generot/driving-assistance-system/README.md

# Driving Assistance System
Дипломна работа 2023 г. на Мартин Наков - Система за напътстване на шофьор на базата на стерео компютърно зрение.
