generot/driving-assistance-system/docs/diagrams/cooler_dimensions.jpg

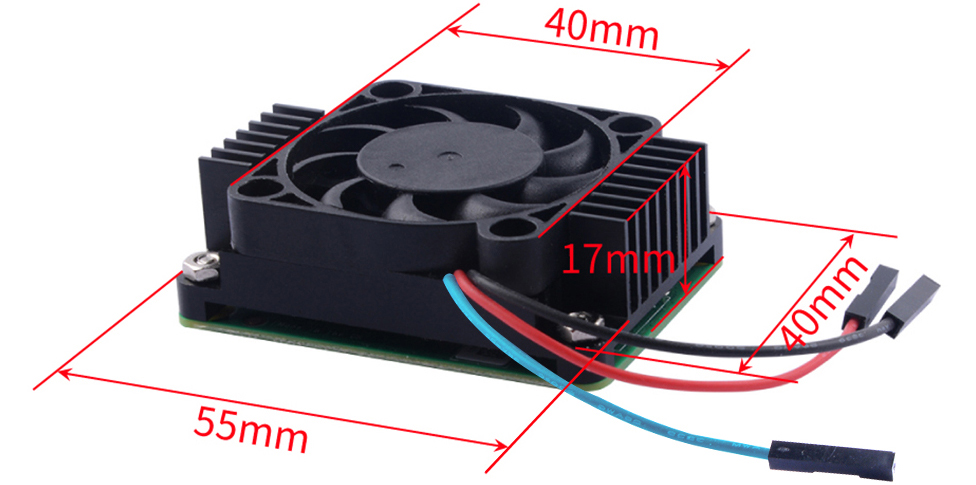
docs/diagrams/cooler_dimensions.jpg
