generot/driving-assistance-system/docs/diagrams/project_concept_5.png

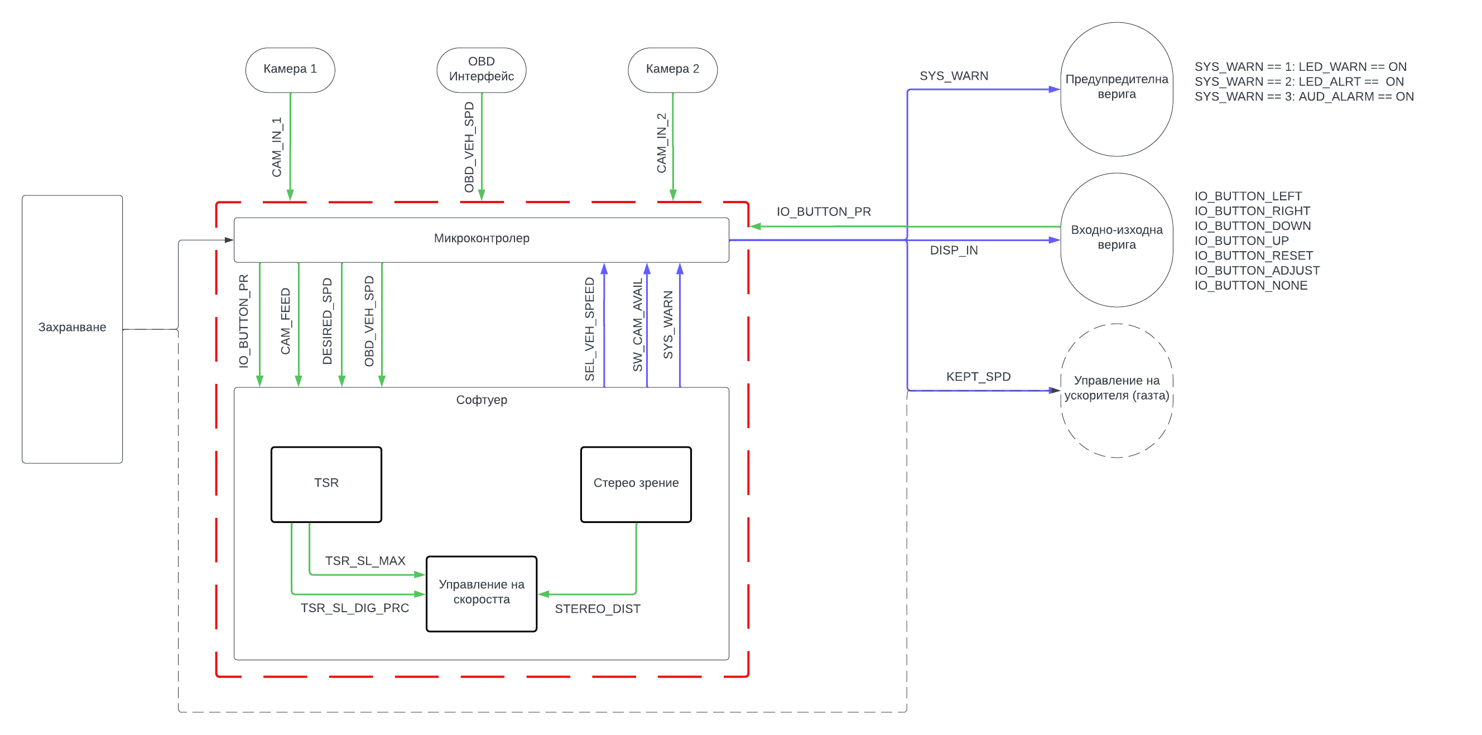
docs/diagrams/project_concept_5.png
