generot/driving-assistance-system/docs/math/concept.png

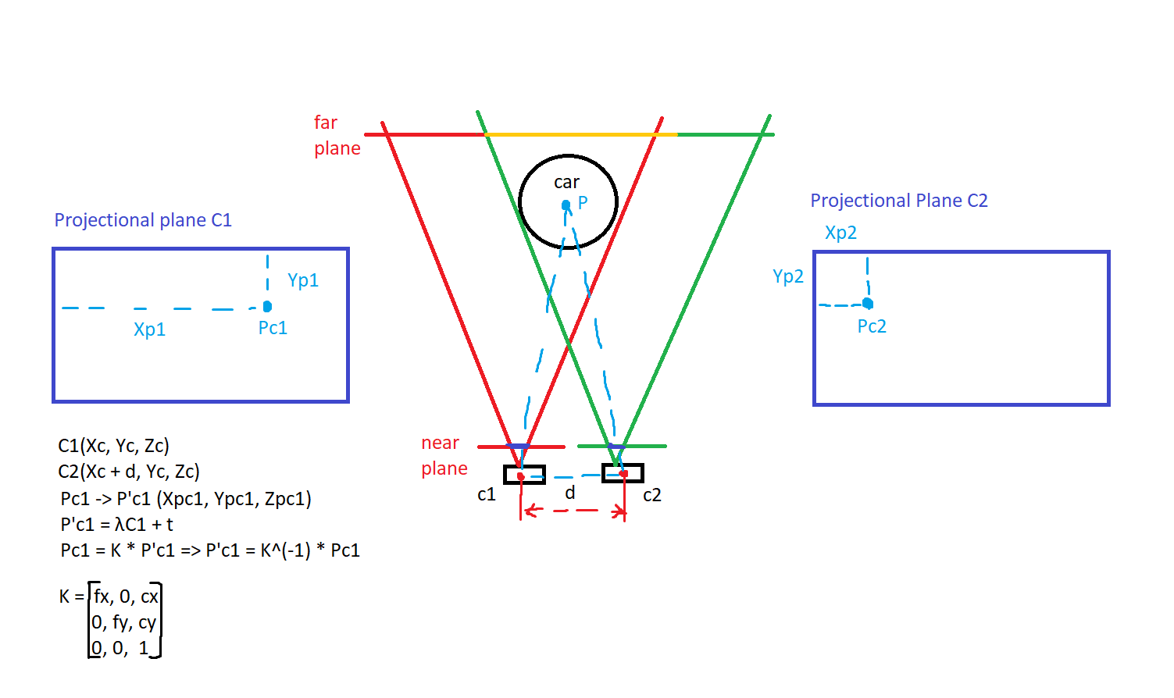
docs/math/concept.png
