generot/driving-assistance-system/models/signs/original/20.png

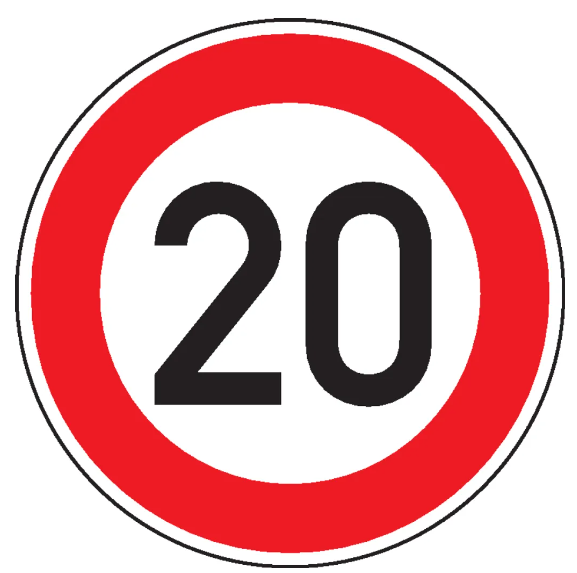
models/signs/original/20.png
