generot/driving-assistance-system/models/signs/original/30.png

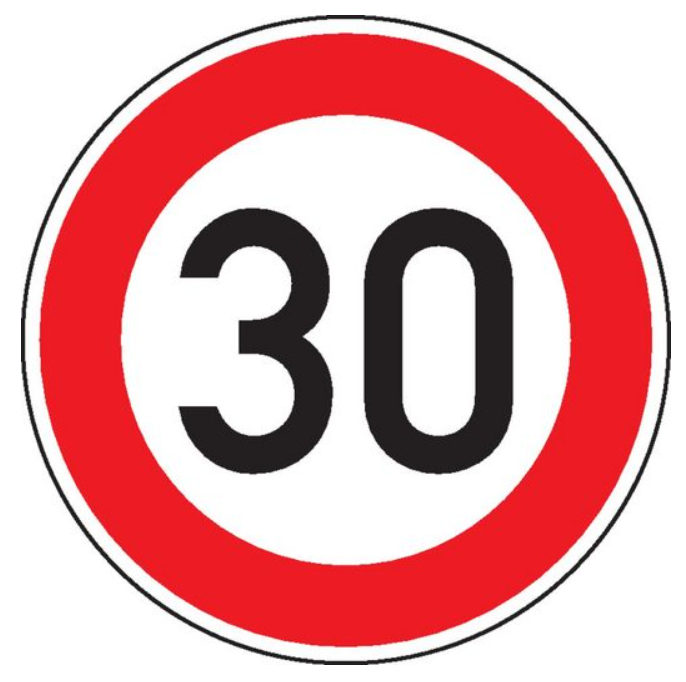
models/signs/original/30.png
