generot/driving-assistance-system/models/signs/original/40.png

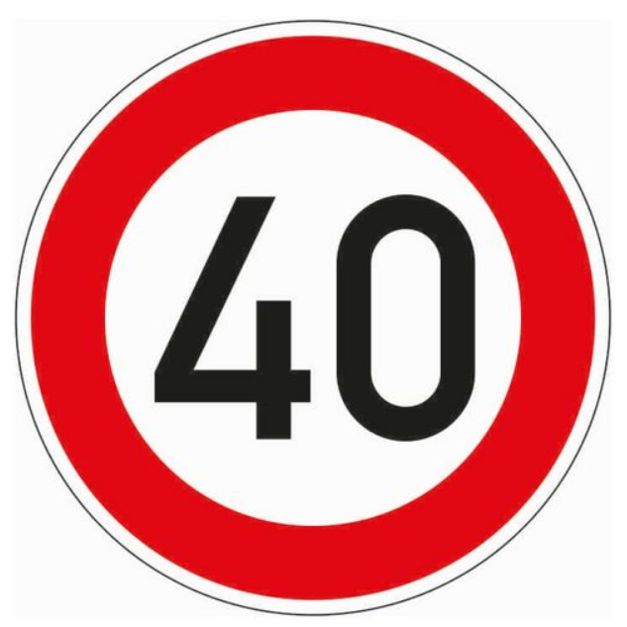
models/signs/original/40.png
