generot/driving-assistance-system/models/signs/original/45.png

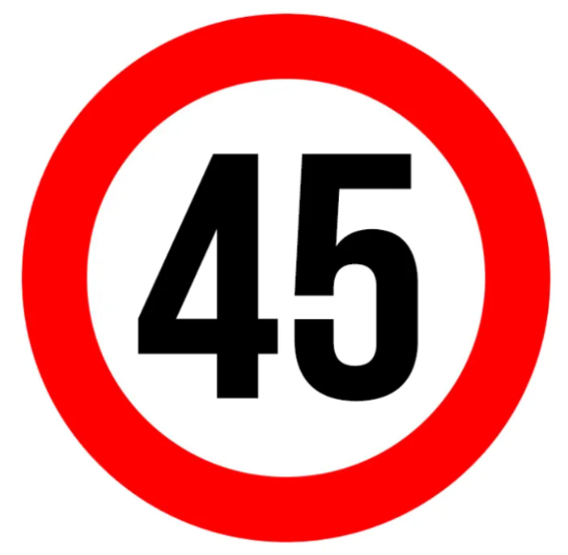
models/signs/original/45.png
