generot/driving-assistance-system/models/signs/original/50.png

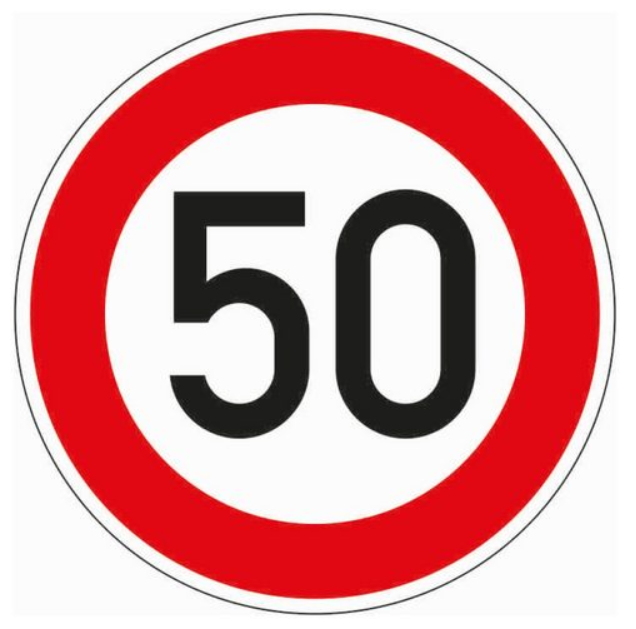
models/signs/original/50.png
