generot/driving-assistance-system/samples/sl_sign1.jpg

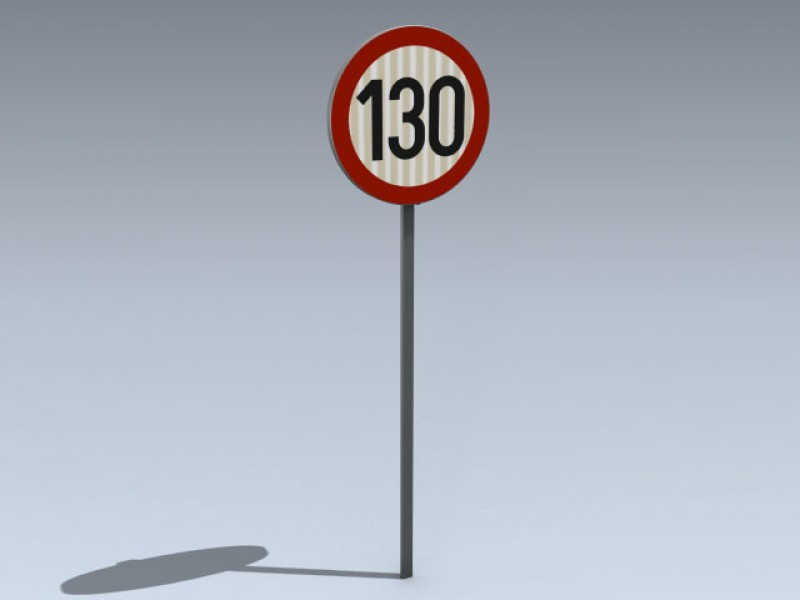
samples/sl_sign1.jpg
