generot/driving-assistance-system/samples/sl_sign3.png

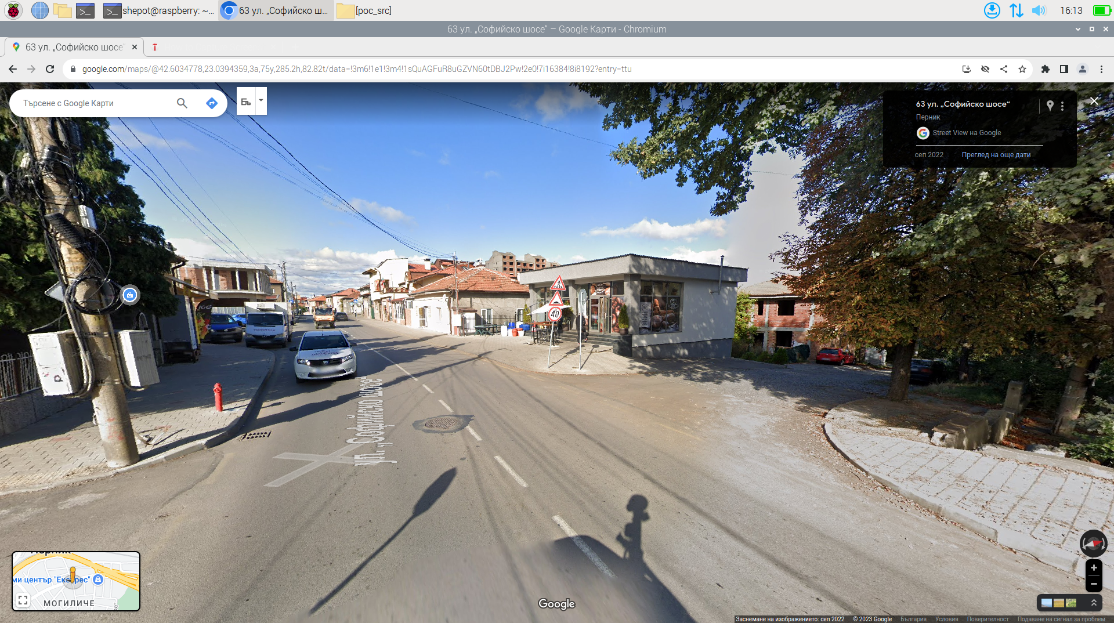
samples/sl_sign3.png
