generot/driving-assistance-system/samples/stereo/left_view_car.bmp

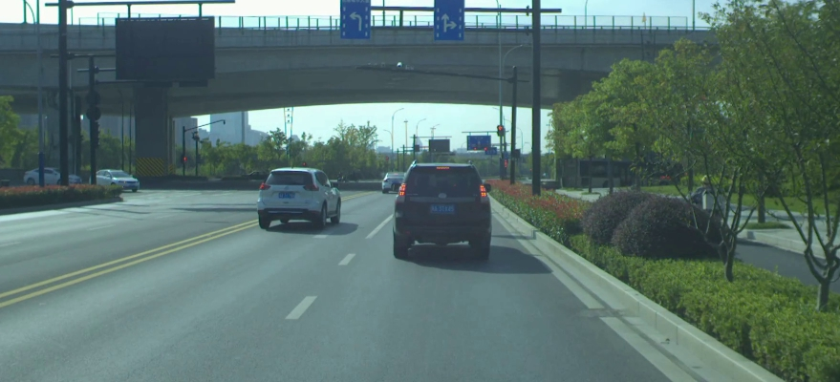
samples/stereo/left_view_car.bmp
