generot/driving-assistance-system/samples/stereo/right_view_car.bmp

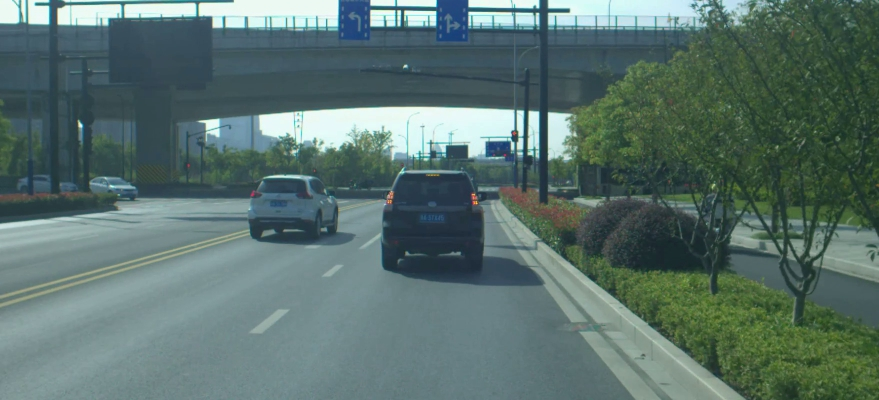
samples/stereo/right_view_car.bmp
