generot/driving-assistance-system/docs/components.xlsx

Sheet: LinkList
Order List
ID | Item | Quantity | Price |  | Provider | Availability (13.09.2023)
 |  |  | EUR (€) | BGN (лв.)
1 | Raspberry Pi Compute Module 4 (2 GB) | 1 | 47.19 | 92.0205 | https://buyzero.de/en/products/compute-module-4-cm4?variant=32090358251622 | In stock
2 |  |  | 62.90 | 122.655 | https://www.welectron.com/Raspberry-Pi-CM4002032-Compute-Module-32-GB-2-GB-RAM_1 | In stock
3 | Raspberry Pi Compute Module IO Board | 1 | 39.90 | 77.805 | https://www.welectron.com/Raspberry-Pi-Compute-Module-CM4-IO-Board_1 | In stock
4 |  |  | 30.87 | 61.74 | https://www.mouser.bg/ProductDetail/Raspberry-Pi/SC0326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 | In stock
5 | Raspberry Pi Camera v2 | 2 | 14.03 | 27.3585 | https://bg.farnell.com/raspberry-pi/rpi-8mp-camera-board/raspberry-pi-camera-board-v2/dp/3677845 | In stock
6 |  |  | 13.57 | 26.46 | https://www.mouser.bg/ProductDetail/Raspberry-Pi/SC0023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 | In stock
7 | Display (SM-RVT70HSMFWN00) | 1 | 50.98 | 99.41 | https://www.tme.eu/bg/details/sm-rvt70hsmfwn00/tft-displei/riverdi/ | In stock
8 |  |  | 49.26 | 96.06 | https://de.riverdi.com/product/high-brightness-ips-display-rvt70hsmfwn00-7-zoll-mipi-dsi-frame | In stock

Sheet: CM4_Vairant
ID | Item | Maximum Power Consumption |  |  | Price |  | Provider |  |  |  | Availability (05.09.2023)
 |  | U [V] | I [mA] | P [W] | EUR (€) | BGN (лв.)
1 | Raspberry Pi Compute Module 4 Lite (8 GB) | 5.0 | 1800.0 | 9.0 | 69.00 | 134.55 | https://www.digikey.bg/en/products/detail/raspberry-pi/SC0687/13530926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 |  |  |  | Out of stock
2 | Raspberry Pi Compute Module 4 Lite (4 GB) |  |  |  | 46.00 | 89.7 | https://www.digikey.bg/en/products/detail/raspberry-pi/SC0683/13530923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 |  |  |  | Out of stock
3 | Raspberry Pi Compute Module IO Board | 12.0 | 0.0 | 0.0 | 32.18 | 62.751 | https://bg.farnell.com/raspberry-pi/cm4io/compute-module-4-board-arm-cortex/dp/3563491 |  |  |  | Out of stock
4 |  |  |  |  | 30.87 | 61.74 | https://www.mouser.bg/ProductDetail/Raspberry-Pi/SC0326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 |  |  |  | In stock
5 | Raspberry Pi Camera v2 | 3.3 | 300.0 | 1.0 | 14.03 | 27.3585 | https://bg.farnell.com/raspberry-pi/rpi-8mp-camera-board/raspberry-pi-camera-board-v2/dp/3677845 |  |  |  | In stock
6 |  |  |  |  | 13.57 | 26.46 | https://www.mouser.bg/ProductDetail/Raspberry-Pi/SC0023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 |  |  |  | In stock
7 | Display (DEM 1024600H TMH-PW-N /O and SM-RVT70HSMFWN00) | 5.1 | 850.0 | 4.3 | 75.17 | 146.58 | https://www.tme.eu/bg/details/dem1024600h-tmhpno/tft-displei/display-elektronik/dem-1024600h-tmh-pw-n-o/ |  |  |  | In stock
8 |  |  |  |  | 49.26 | 96.06 | https://www.mouser.bg/ProductDetail/Riverdi/RVT70HSMFWN00?qs=7D1LtPJG0i2G%2FPnN%252BYe%252ByQ%3D%3D |  |  |  | Out of stock
9 | Запалка (Car Lighter Plug) | 0.0 | 0.0 | 0.0 | 3.03 | 5.9 | https://vikiwat.com/kabel-zahranvasch-1.2m-s-buksa-1.5x5.5x9.5mm-504071.html |  |  |  | In stock
10 |  |  |  |  | 1.49 | 2.9 | https://vikiwat.com/product/20033/shtepsel-za-zapalka-na-kola-12vdc.html |  |  |  | In stock
11 | DC/DC Converter * | UA | UA | UA | 3.68 | 7.176 | https://store.comet.bg/Catalogue/Product/51791/ |  |  |  | In stock
12 |  |  |  |  | 7.73 | 15.0735 | https://store.comet.bg/Catalogue/Product/46876/ |  |  |  | In stock
 | Total | UA | 2950.0 | 14.3 | UA |  | - |  |  |  | -
 | Notes |  | Variant 1a (8 GB RAM) |  |  |  |  | Additional Components
 | UA - Unapplicable |  | Item |  | Price (BGN) | ID |  | Item | Price (BGN) | Provider
 | IO платката (по спецификация) тегли толкова ток от източника, колкото е товара, свързан към нея (+- няколко mА) |  | RasPI CM4 Lite 8 GB |  | 134.55 | 1 |  | Seeed 114070161 | 22.91 | https://www.mouser.bg/ProductDetail/Seeed-Studio/114070161?qs=TuK3vfAjtkXtgDd7IWY4BQ%3D%3D
 |  |  | RasPI CMIO Board |  | 61.74 | 4
 |  |  | 2 x RasPI Camera v2 |  | 28.06 | 5
 | * - Тъй като по-голямата част от компонентите са за Raspberry PI по дизайн, DC/DC конвертор може би няма да е нужен, IO платката "би трябвало" да снабди всеки важен компонент с достатъчно ток. Евентуално, ако към веригата ще се добавя по-изискващ компонент (като серво/електромотор), може би няма да е зле да се вземе поне по-маломощния конвертор (46876) |  | SM-RVT70HSMFWN00 |  | 96.06 | 7
 |  |  | Car Lighter Plug |  | 5.90 | 9
 |  |  | DC/DC CNV 51791 |  | 7.17 | 11
 |  |  | Total |  | 333.48 | -
 |  |  | Variant 1b (4 GB RAM)
 |  |  | Item |  | Price (BGN) | ID
 |  |  | RasPI CM4 Lite 4 GB |  | 89.70 | 1
 |  |  | RasPI CMIO Board |  | 61.74 | 4
 |  |  | 2 x RasPI Camera v2 |  | 28.06 | 5
 |  |  | SM-RVT70HSMFWN00 |  | 98.65 | 7
 | В таблицата има някои компоненти, които са взаимнозаменяеми с други, които са по-евтини, но по-маломощни. Ще направя два възможни списъка с компоненти за купуване. |  | Car Lighter Plug |  | 5.90 | 9
 |  |  | DC/DC CNV 51791 |  | 7.17 | 11
 |  |  | Total |  | 314.13 | -

Sheet: RPI4_Variant
ID | Item |  |  | Maximum Power Consumption |  |  | Price |  | Provider | Availability (05.09.2023)
 |  |  |  | U [V] | I [mA] | P [W] | EUR (€) | BGN (лв.)
1 | Raspberry Pi 4 |  |  | 5.0 | 3000.0 | 15.0 | 68.96 | 134.472 | https://bg.farnell.com/raspberry-pi/rpi4-modbp-8gb/raspberry-pi-4-model-b-cortex/dp/3369503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 | Out of stock
 |  |  |  |  |  |  | 56.00 | 109.2 | https://www.tme.eu/bg/details/rpi-4b-4g/ednoplatkovi-kompiutri/raspberry-pi/raspberry-pi-4-4g-model-b/ | Out of stock
2 | Trust Spotlight |  |  | 5.0 | 300.0 | 1.5 | 23.13 | 45.1035 | https://bg.farnell.com/trust/16428/webcam-spotlight-webcam-pro-trust/dp/3498501 | In stock
3 | Dynamode M-1100M |  |  | 5.0 | 300.0 | 1.5 | 15.13 | 29.5035 | https://bg.farnell.com/dynamode/m-1100m/webcam-usb-2mp-microphone-led/dp/3531742 | In stock
4 | Display (DEM 1024600H TMH-PW-N /O and SM-RVT70HSMFWN00) |  |  | 5.1 | 850.0 | 4.3 | 75.17 | 146.58 | https://www.tme.eu/bg/details/dem1024600h-tmhpno/tft-displei/display-elektronik/dem-1024600h-tmh-pw-n-o/ | In stock
5 |  |  |  |  |  |  | 50.59 | 98.65 | https://www.tme.eu/bg/details/sm-rvt70hsmfwn00/tft-displei/riverdi/ | In stock
6 | Запалка (Car Lighter Plug) |  |  | 0.0 | 0.0 | 0.0 | 3.03 | 5.9 | https://vikiwat.com/kabel-zahranvasch-1.2m-s-buksa-1.5x5.5x9.5mm-504071.html | In stock
7 |  |  |  |  |  |  | 1.49 | 2.9 | https://vikiwat.com/product/20033/shtepsel-za-zapalka-na-kola-12vdc.html | In stock
8 | DC/DC Converter * |  |  | UA | UA | UA | 18.60 | 36.27 | https://www.tme.eu/bg/details/psd-30a-5/preobrazuvateli-dc-dc/mean-well/ | Out of stock
9 |  |  |  |  |  |  | 7.73 | 15.0735 | https://store.comet.bg/Catalogue/Product/46876/ | In stock
 | Total |  |  | UA | 4450.0 | 22.3 | UA |  | - | -
 | Variant 2
 | Item | Price (BGN) | ID
 | RasPI 4 | 134.47 | 1
 | 2 x Dynamode M-1100M | 59 | 3
 | SM-RVT70HSMF | 98.65 | 5
 | Car Lighter Plug | 5.9 | 6
 | DC/DC Converter | 15.07 | 9
 | Total | 336
