generot/driving-assistance-system/docs/schematics/aac/models_3d/MAX3232.STEP

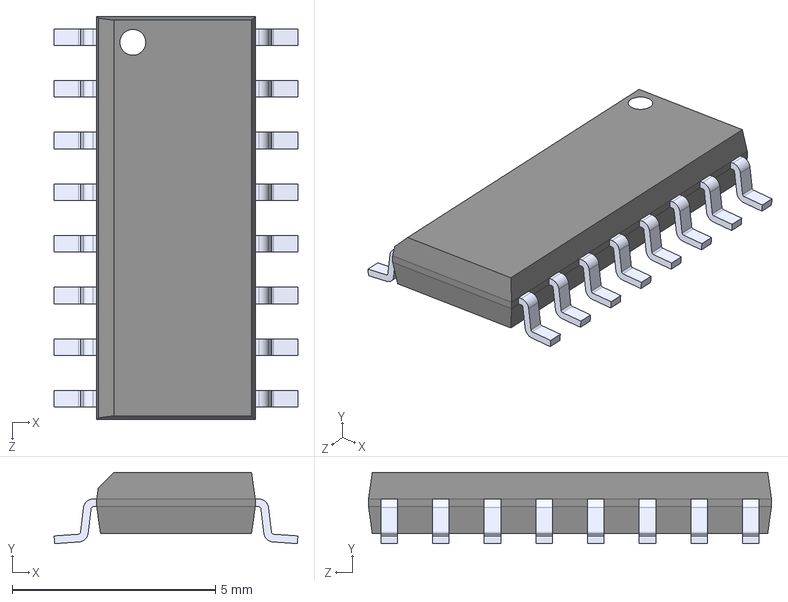
[picture p15: CAD file, 2023-11-07]
docs/schematics/aac/models_3d/MAX3232.STEP
5.99 x 1.75 x 9.91 mm
