generot/driving-assistance-system/docs/schematics/aac/models_3d/WE-PD4_Typ_L_4.stp

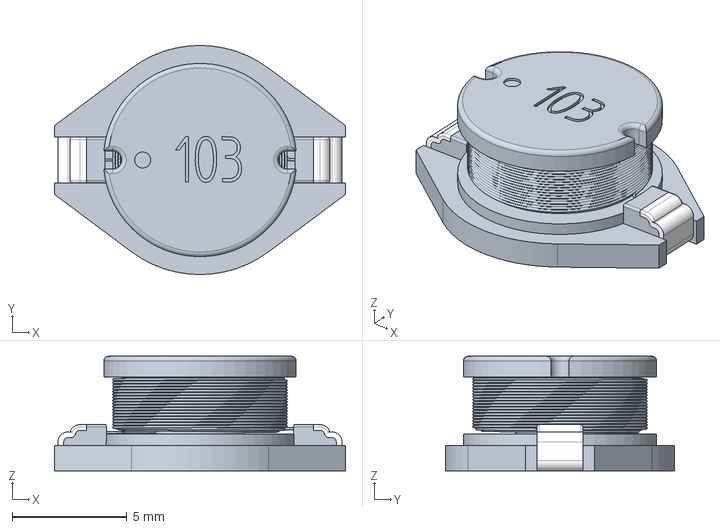
[picture p16: CAD file, 2023-11-07]
docs/schematics/aac/models_3d/WE-PD4_Typ_L_4.stp
12.7 x 10.0 x 5.00 mm
