generot/driving-assistance-system/docs/schematics/aac/models_3d/Trimmer_Piher_PT-15.step

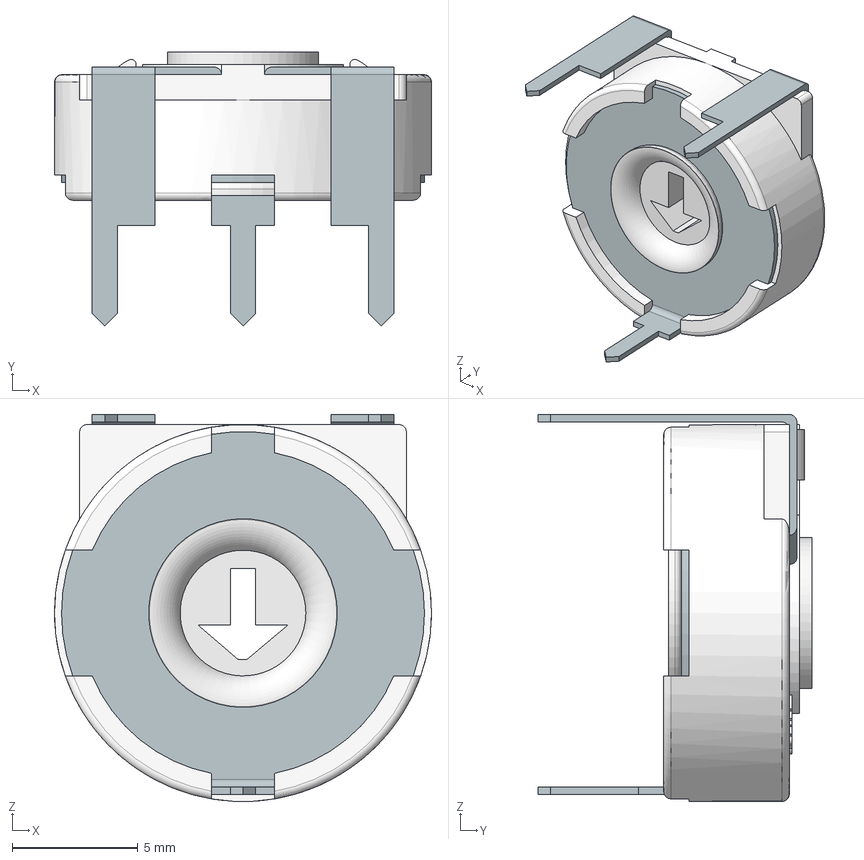
[picture p17: CAD file, 2023-11-07]
docs/schematics/aac/models_3d/Trimmer_Piher_PT-15.step
15.0 x 10.9 x 15.4 mm
Corps_PT-15
Axe
Broche 1
