generot/driving-assistance-system/docs/diagrams/L2_testing.png

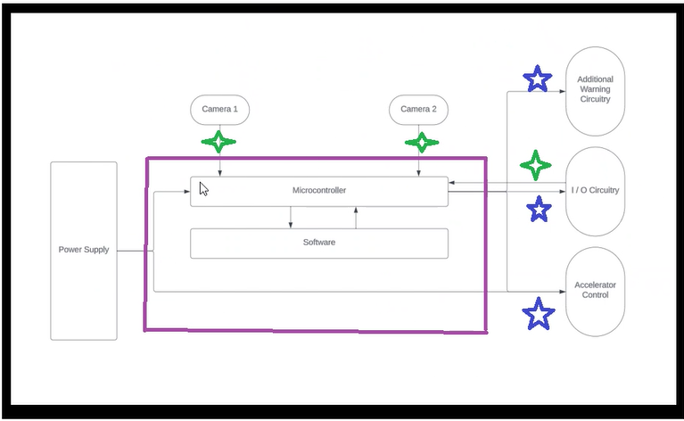
docs/diagrams/L2_testing.png
