generot/driving-assistance-system/samples/calibration/cm4/cam0/calib_3.jpg

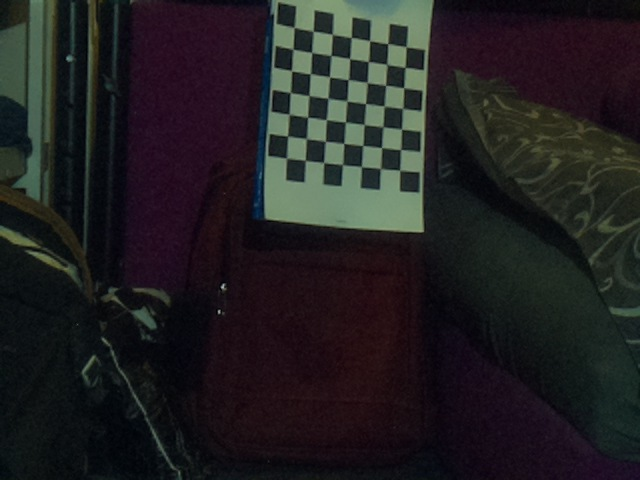
samples/calibration/cm4/cam0/calib_3.jpg
