generot/driving-assistance-system/samples/calibration/cm4/cam0/calib_13.jpg

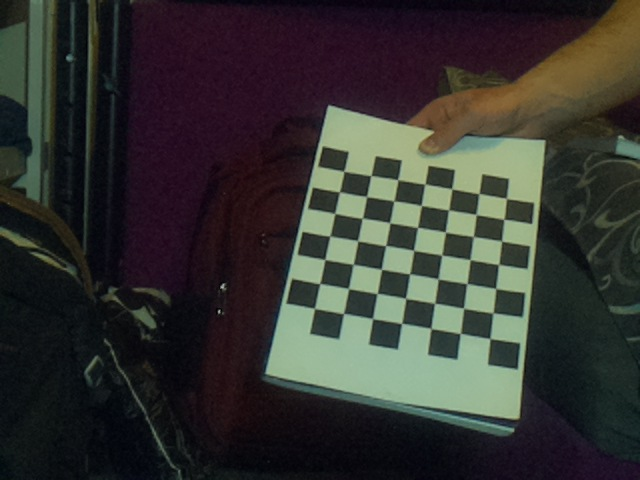
samples/calibration/cm4/cam0/calib_13.jpg
