generot/driving-assistance-system/samples/calibration/cm4/cam1/calib_1.jpg

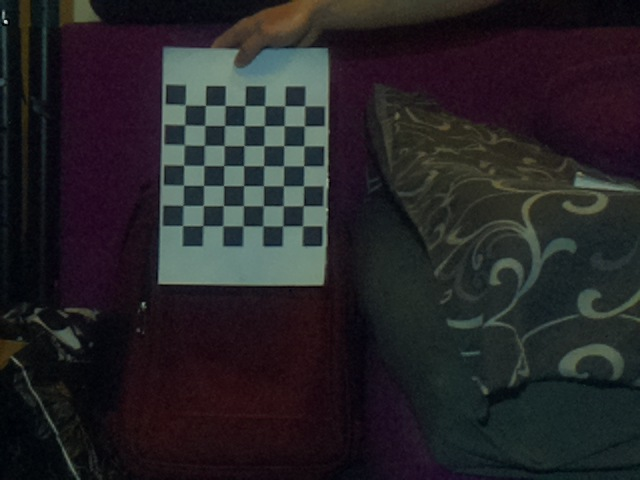
samples/calibration/cm4/cam1/calib_1.jpg
