generot/driving-assistance-system/samples/calibration/cm4/cam1/calib_13.jpg

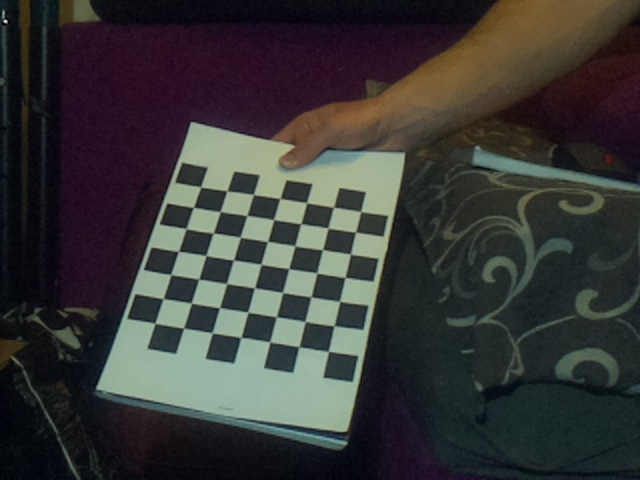
samples/calibration/cm4/cam1/calib_13.jpg
