generot/driving-assistance-system/samples/calibration/test/sam_a32_p1.jpg

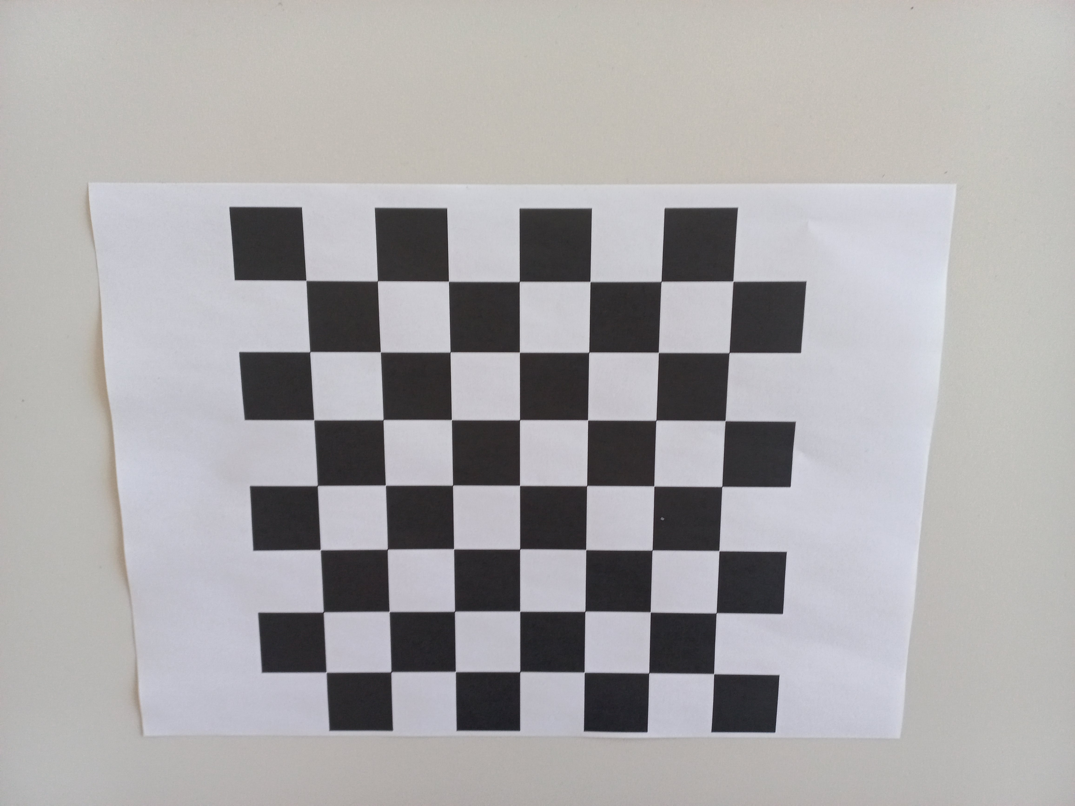
samples/calibration/test/sam_a32_p1.jpg
