generot/driving-assistance-system/samples/calibration/test/sam_a32_p3.jpg

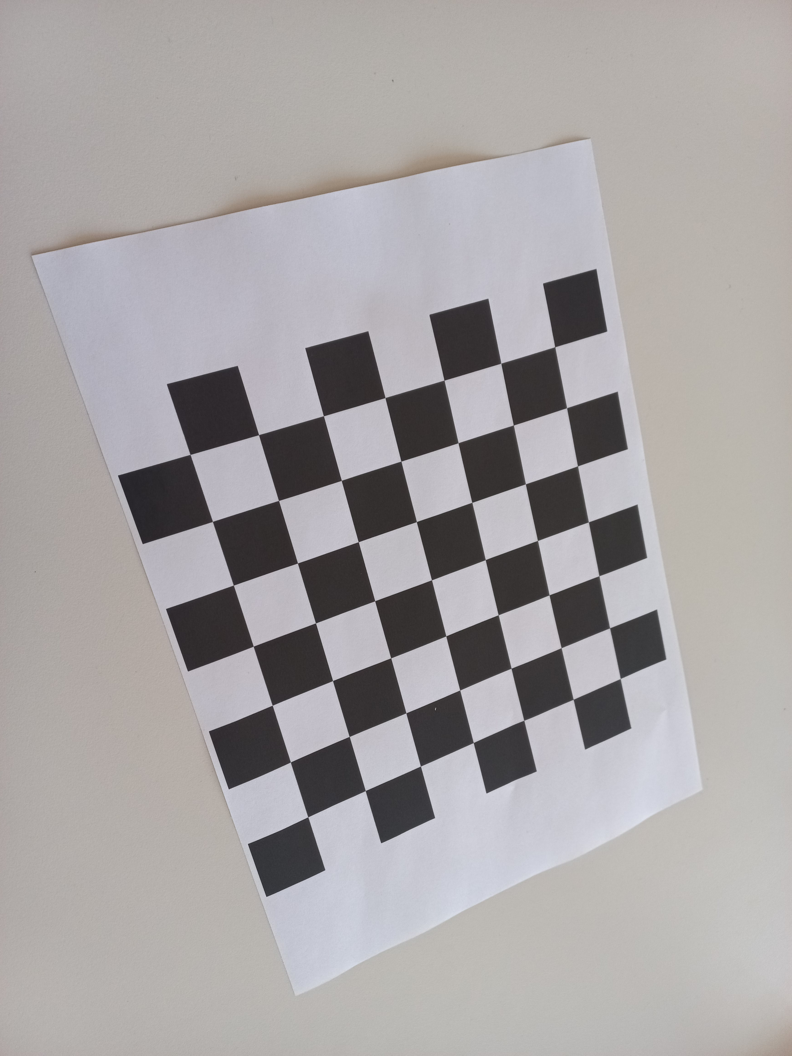
samples/calibration/test/sam_a32_p3.jpg
