generot/driving-assistance-system/samples/calibration/test/sam_a32_p4.jpg

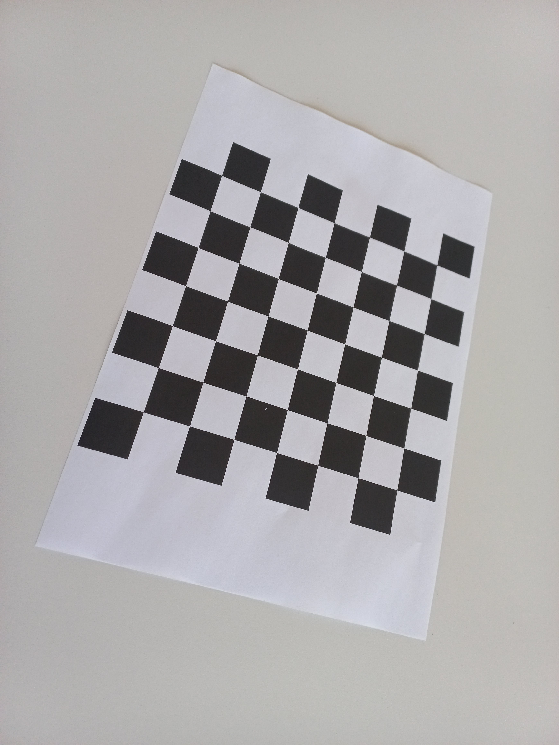
samples/calibration/test/sam_a32_p4.jpg
