generot/driving-assistance-system/docs/schematics/aac/Shield.kicad_pcb

## KiCad design docs/schematics/aac/Shield.kicad_pcb (2023-11-24)

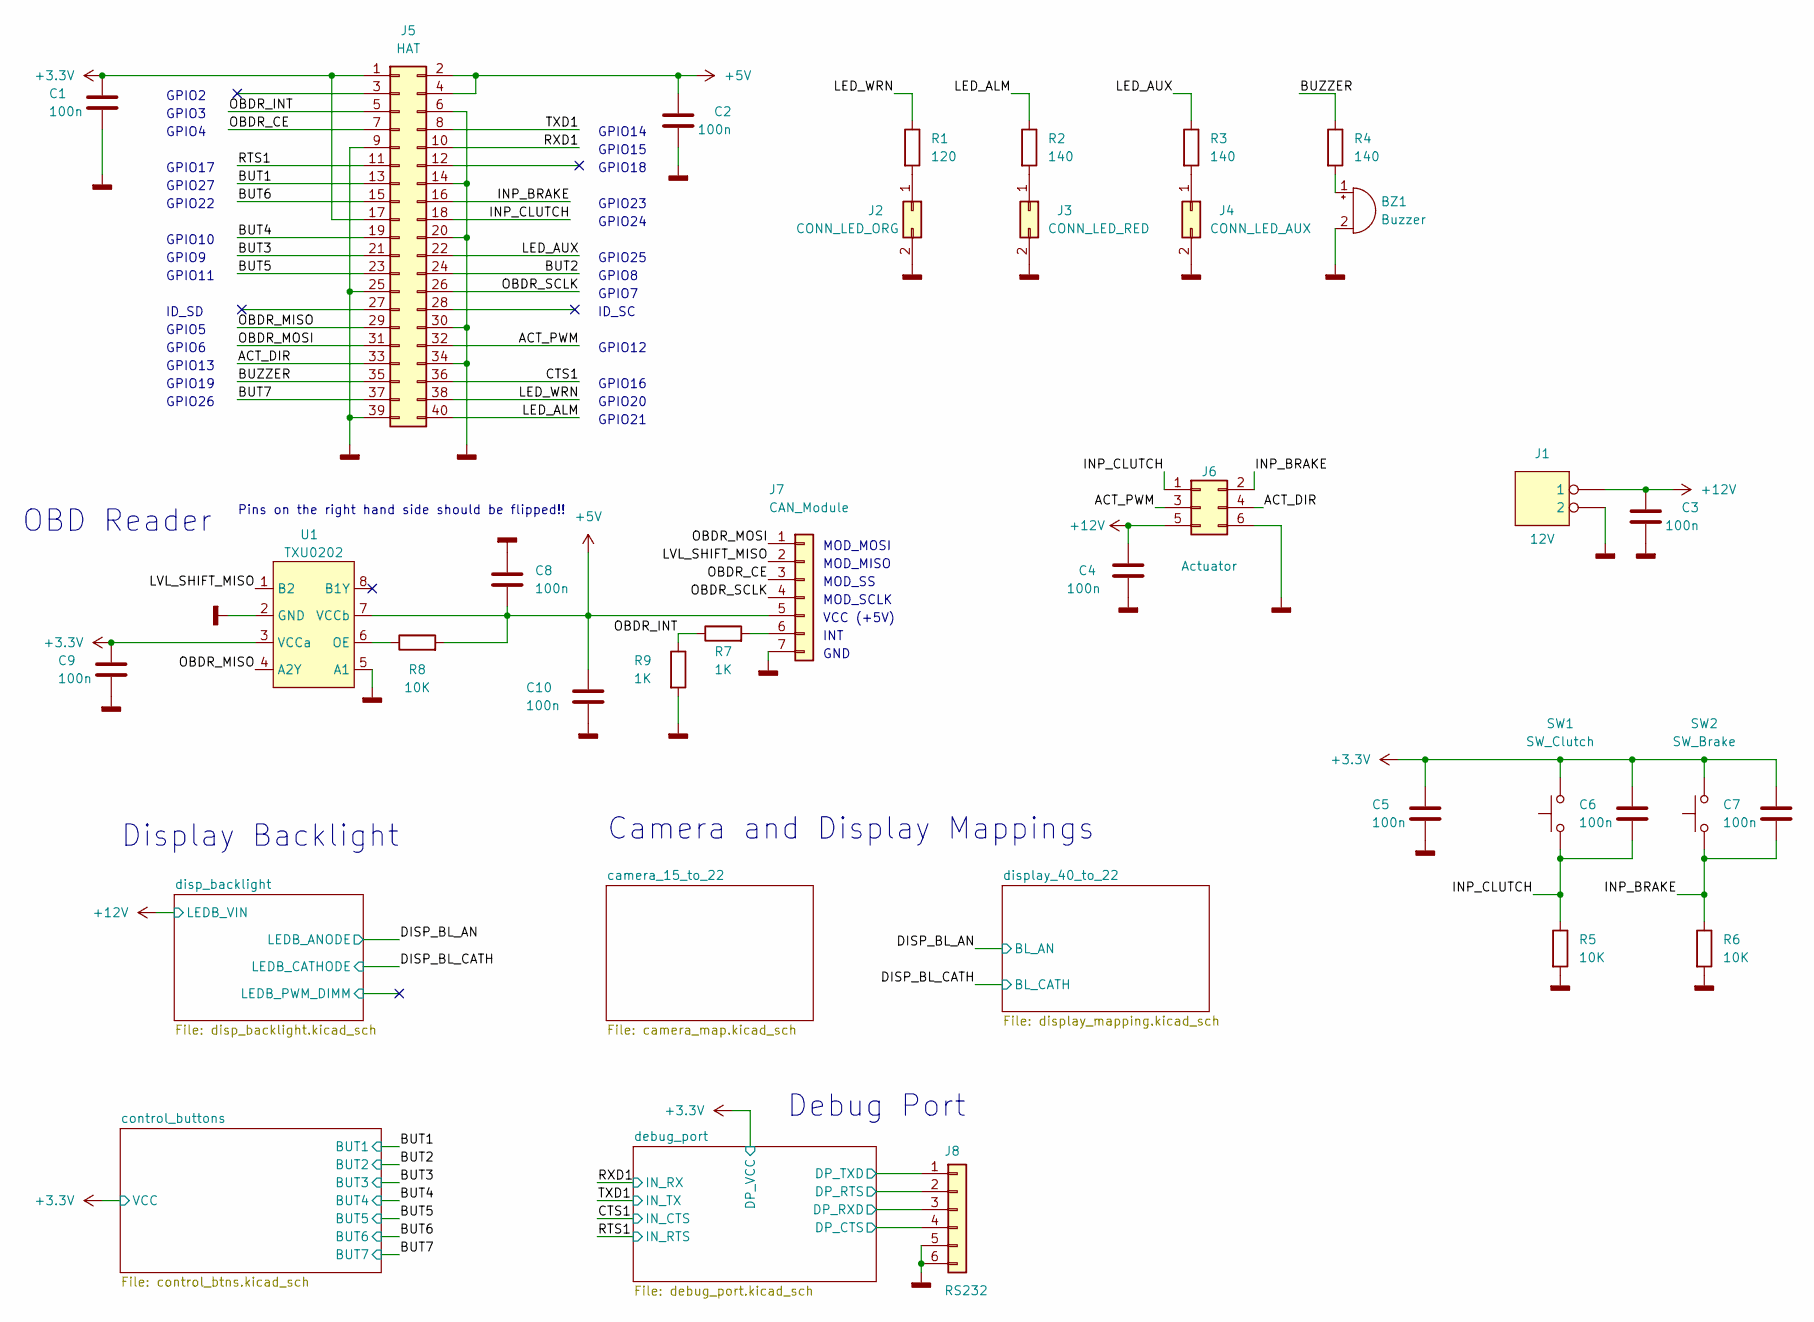
[picture p44: schematic Shield.kicad_sch, DA_Shield_Schematic]

Parts:
BZ1: Buzzer; Buzzer_12x9.5RM7.6
C1, C2, C3, C4, C5, C6, C7, C8, C9, C10: 100n; C_0805_2012Metric
J1: 12V; PinHeader_1x02_P2.54mm_Horizontal
J2: CONN_LED_ORG; PinHeader_2x01_P2.54mm_Horizontal
J3: CONN_LED_RED; PinHeader_2x01_P2.54mm_Horizontal
J4: CONN_LED_AUX; PinHeader_2x01_P2.54mm_Horizontal
J5: HAT; PinHeader_2x20_P2.54mm_Vertical
J6: Actuator; PinHeader_2x03_P2.54mm_Vertical
J7: CAN_Module; PinHeader_1x07_P2.54mm_Vertical
J8: RS232; PinHeader_1x06_P2.54mm_Horizontal
R1: 120; R_0805_2012Metric
R2, R3, R4: 140; R_0805_2012Metric
R5, R6, R8: 10K; R_0805_2012Metric
R7, R9: 1K; R_0805_2012Metric
SW1: SW_Clutch; PinHeader_2x01_P2.54mm_Horizontal
SW2: SW_Brake; PinHeader_2x01_P2.54mm_Horizontal
U1: TXU0202; VSSOP-8_2.4x2.1mm_P0.5mm

Connections:
+3.3V: C1.1, C5.1, C6.1, C7.1, C9.1, J5.1, J5.17, SW1.2, SW2.2, U1.3 (VCCa); also elsewhere on the board
+5V: C2.1, C8.1, C10.2, J5.2, J5.4, J7.5, R8.2, U1.7 (VCCb)
+12V: C3.1, C4.1, J1.1, J6.5; also elsewhere on the board
/ACT_DIR: J5.33, J6.4
/ACT_PWM: J5.32, J6.3
/BUT1: J5.13; also elsewhere on the board
/BUT2: J5.24; also elsewhere on the board
/BUT3: J5.21; also elsewhere on the board
/BUT4: J5.19; also elsewhere on the board
/BUT5: J5.23; also elsewhere on the board
/BUT6: J5.15; also elsewhere on the board
/BUT7: J5.37; also elsewhere on the board
/BUZZER: J5.35, R4.1
/CTS1: J5.36; also elsewhere on the board
/INP_BRAKE: C7.2, J5.16, J6.2, R6.1, SW2.1
/INP_CLUTCH: C6.2, J5.18, J6.1, R5.1, SW1.1
/LED_ALM: J5.40, R2.1
/LED_AUX: J5.22, R3.1
/LED_WRN: J5.38, R1.1
/LVL_SHIFT_MISO: J7.2, U1.1 (B2)
/OBDR_CE: J5.7, J7.3
/OBDR_INT: J5.5, R7.1, R9.1
/OBDR_MISO: J5.29, U1.4 (A2Y)
/OBDR_MOSI: J5.31, J7.1
/OBDR_SCLK: J5.26, J7.4
/RTS1: J5.11; also elsewhere on the board
/RXD1: J5.10; also elsewhere on the board
/TXD1: J5.8; also elsewhere on the board
/debug_port/DP_CTS: J8.4; also elsewhere on the board
/debug_port/DP_RTS: J8.2; also elsewhere on the board
/debug_port/DP_RXD: J8.3; also elsewhere on the board
/debug_port/DP_TXD: J8.1; also elsewhere on the board
GNDD: BZ1.2 (+), C1.2, C2.2, C3.2, C4.2, C5.2, C8.2, C9.2, C10.1, J1.2, J2.2, J3.2, J4.2, J5.6, J5.9, J5.14, J5.20, J5.25, J5.30, J5.34, J5.39, J6.6, J7.7, J8.5, J8.6, R5.2, R6.2, R9.2, U1.2 (GND), U1.5 (A1); also elsewhere on the board
unnamed: BZ1.1 (-), R4.2
unnamed: J2.1, R1.2
unnamed: J3.1, R2.2
unnamed: J4.1, R3.2
unnamed: J7.6, R7.2
unnamed: R8.1, U1.6 (OE)

Notes on the sheet:
INT
OBD Reader
GPIO15
GPIO2
GPIO5
GPIO25
GPIO18
GPIO4
GND
GPIO11
MOD_MISO
GPIO8
GPIO10
GPIO16
GPIO7
GPIO23
GPIO22
GPIO17
MOD_SS
MOD_MOSI
GPIO14
GPIO6
GPIO19
GPIO24
Pins on the right hand side should be flipped!!
GPIO9
GPIO3
MOD_SCLK
GPIO20
GPIO21
GPIO12
GPIO26
ID_SC
GPIO27
Display Backlight
GPIO13
ID_SD
Debug Port
VCC (+5V)
Camera and Display Mappings

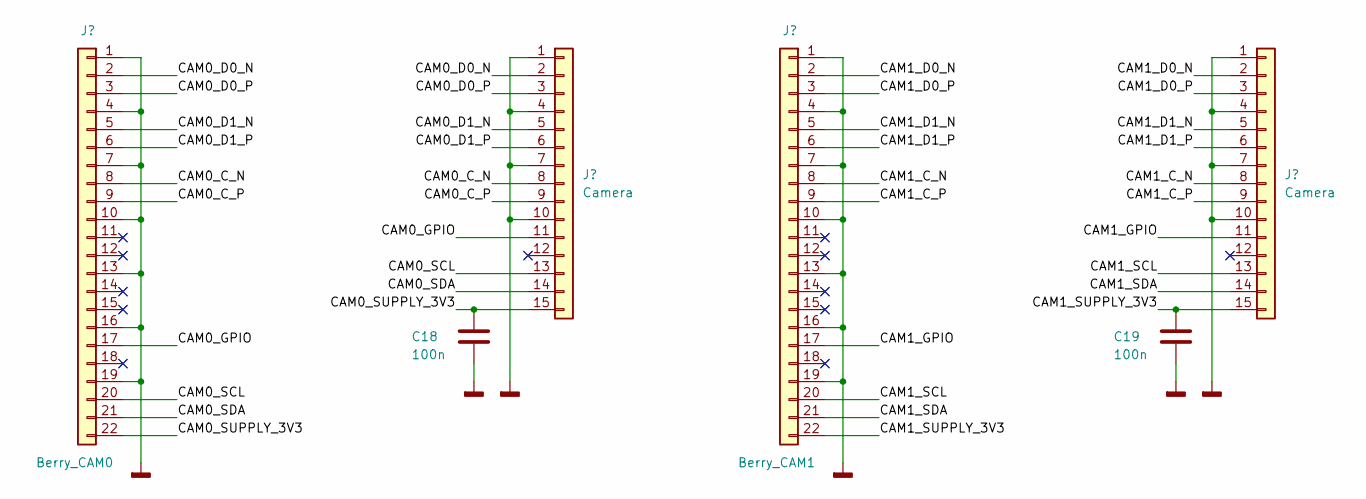
[picture p45: schematic camera_map.kicad_sch]

Parts:
C18, C19: 100n; C_0805_2012Metric
J9, J10: Camera; TE_1-84952-5_1x15-1MP_P1.0mm_Horizontal
J11: Berry_CAM0; Hirose_FH12-22S-0.5SH_1x22-1MP_P0.50mm_Horizontal
J12: Berry_CAM1; Hirose_FH12-22S-0.5SH_1x22-1MP_P0.50mm_Horizontal

Connections:
/camera_15_to_22/CAM0_C_N: J9.8, J11.8
/camera_15_to_22/CAM0_C_P: J9.9, J11.9
/camera_15_to_22/CAM0_D0_N: J9.2, J11.2
/camera_15_to_22/CAM0_D0_P: J9.3, J11.3
/camera_15_to_22/CAM0_D1_N: J9.5, J11.5
/camera_15_to_22/CAM0_D1_P: J9.6, J11.6
/camera_15_to_22/CAM0_GPIO: J9.11, J11.17
/camera_15_to_22/CAM0_SCL: J9.13, J11.20
/camera_15_to_22/CAM0_SDA: J9.14, J11.21
/camera_15_to_22/CAM0_SUPPLY_3V3: C18.1, J9.15, J11.22
/camera_15_to_22/CAM1_C_N: J10.8, J12.8
/camera_15_to_22/CAM1_C_P: J10.9, J12.9
/camera_15_to_22/CAM1_D0_N: J10.2, J12.2
/camera_15_to_22/CAM1_D0_P: J10.3, J12.3
/camera_15_to_22/CAM1_D1_N: J10.5, J12.5
/camera_15_to_22/CAM1_D1_P: J10.6, J12.6
/camera_15_to_22/CAM1_GPIO: J10.11, J12.17
/camera_15_to_22/CAM1_SCL: J10.13, J12.20
/camera_15_to_22/CAM1_SDA: J10.14, J12.21
/camera_15_to_22/CAM1_SUPPLY_3V3: C19.1, J10.15, J12.22
GNDD: C18.2, C19.2, J9.1, J9.4, J9.7, J9.10, J9.MP, J10.1, J10.4, J10.7, J10.10, J10.MP, J11.1, J11.4, J11.7, J11.10, J11.13, J11.16, J11.19, J11.MP, J12.1, J12.4, J12.7, J12.10, J12.13, J12.16, J12.19, J12.MP; also elsewhere on the board

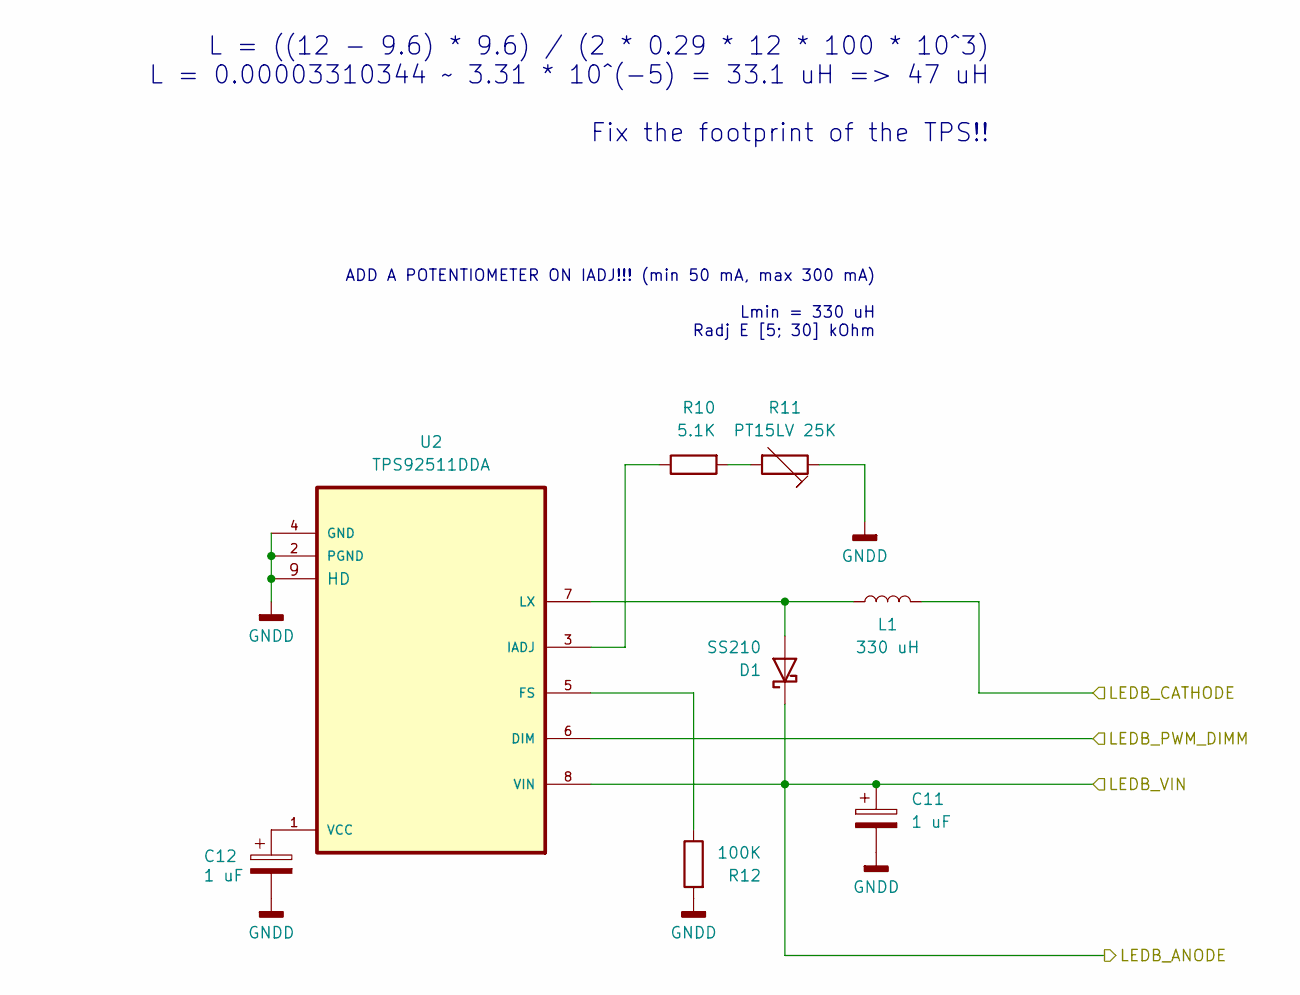
[picture p46: schematic disp_backlight.kicad_sch]

Parts:
C11, C12: 1 uF; C_0805_2012Metric
D1: SS210; D_SMB
L1: 330 uH; L_SigTra_SC3316F
R10: 5.1K; R_0805_2012Metric
R11: PT15LV 25K; Potentiometer_ACP_CA14V-15_Vertical
R12: 100K; R_0805_2012Metric
U2: TPS92511DDA; SOIC-8-1EP_3.9x4.9mm_P1.27mm_EP2.29x3mm_ThermalVias

Connections:
+12V: C11.1, D1.1 (K), U2.8 (VIN); also elsewhere on the board
/DISP_BL_CATH: L1.2; also elsewhere on the board
/disp_backlight/LEDB_PWM_DIMM: U2.6 (DIM)
GNDD: C11.2, C12.2, R11.1, R12.2, U2.2 (PGND), U2.4 (GND), U2.9 (HD); also elsewhere on the board
unnamed: D1.2 (A), L1.1, U2.7 (LX)
unnamed: R10.2, R11.2
unnamed: R12.1, U2.5 (FS)
unnamed: R10.1, U2.3 (IADJ)
unnamed: C12.1, U2.1 (VCC)

Notes on the sheet:
ADD A POTENTIOMETER ON IADJ!!! (min 50 mA, max 300 mA) Lmin = 330 uH Radj E [5; 30] kOhm
L = ((12 - 9.6) * 9.6) / (2 * 0.29 * 12 * 100 * 10^3) L = 0.00003310344 ~ 3.31 * 10^(-5) = 33.1 uH => 47 uH Fix the footprint of the TPS!!

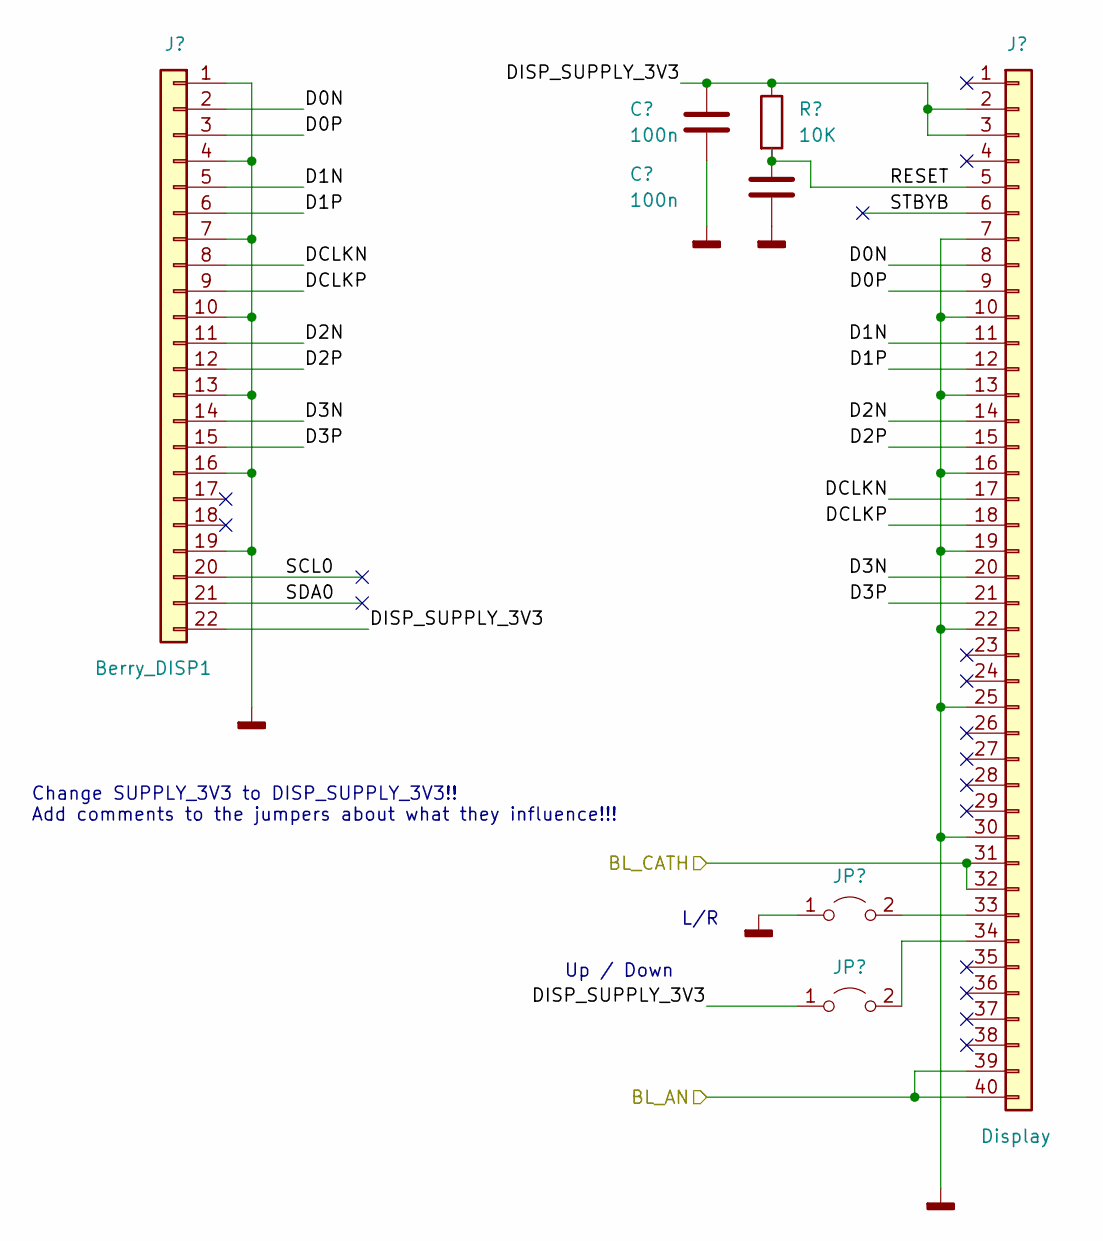
[picture p47: schematic display_mapping.kicad_sch]

Parts:
C28, C29: 100n; C_0805_2012Metric
J20: Berry_DISP1; Hirose_FH12-22S-0.5SH_1x22-1MP_P0.50mm_Horizontal
J21: Display; Hirose_FH12-40S-0.5SH_1x40-1MP_P0.50mm_Horizontal
JP1, JP2: Jumper_2_Open; SolderJumper-2_P1.3mm_Open_RoundedPad1.0x1.5mm
R20: 10K; R_0805_2012Metric

Connections:
+12V: J21.39, J21.40; also elsewhere on the board
/DISP_BL_CATH: J21.31, J21.32; also elsewhere on the board
/display_40_to_22/D0N: J20.2, J21.8
/display_40_to_22/D0P: J20.3, J21.9
/display_40_to_22/D1N: J20.5, J21.11
/display_40_to_22/D1P: J20.6, J21.12
/display_40_to_22/D2N: J20.11, J21.14
/display_40_to_22/D2P: J20.12, J21.15
/display_40_to_22/D3N: J20.14, J21.20
/display_40_to_22/D3P: J20.15, J21.21
/display_40_to_22/DCLKN: J20.8, J21.17
/display_40_to_22/DCLKP: J20.9, J21.18
/display_40_to_22/DISP_SUPPLY_3V3: C28.1, J20.22, J21.2, J21.3, JP2.1 (A), R20.1
/display_40_to_22/RESET: C29.1, J21.5, R20.2
/display_40_to_22/SCL0: J20.20
/display_40_to_22/SDA0: J20.21
/display_40_to_22/STBYB: J21.6
GNDD: C28.2, C29.2, J20.1, J20.4, J20.7, J20.10, J20.13, J20.16, J20.19, J20.MP, J21.7, J21.10, J21.13, J21.16, J21.19, J21.22, J21.25, J21.30, J21.MP, JP1.1 (A); also elsewhere on the board
unnamed: J21.33, JP1.2 (B)
unnamed: J21.34, JP2.2 (B)

Notes on the sheet:
L/R
Change SUPPLY_3V3 to DISP_SUPPLY_3V3!! Add comments to the jumpers about what they influence!!!
Up / Down

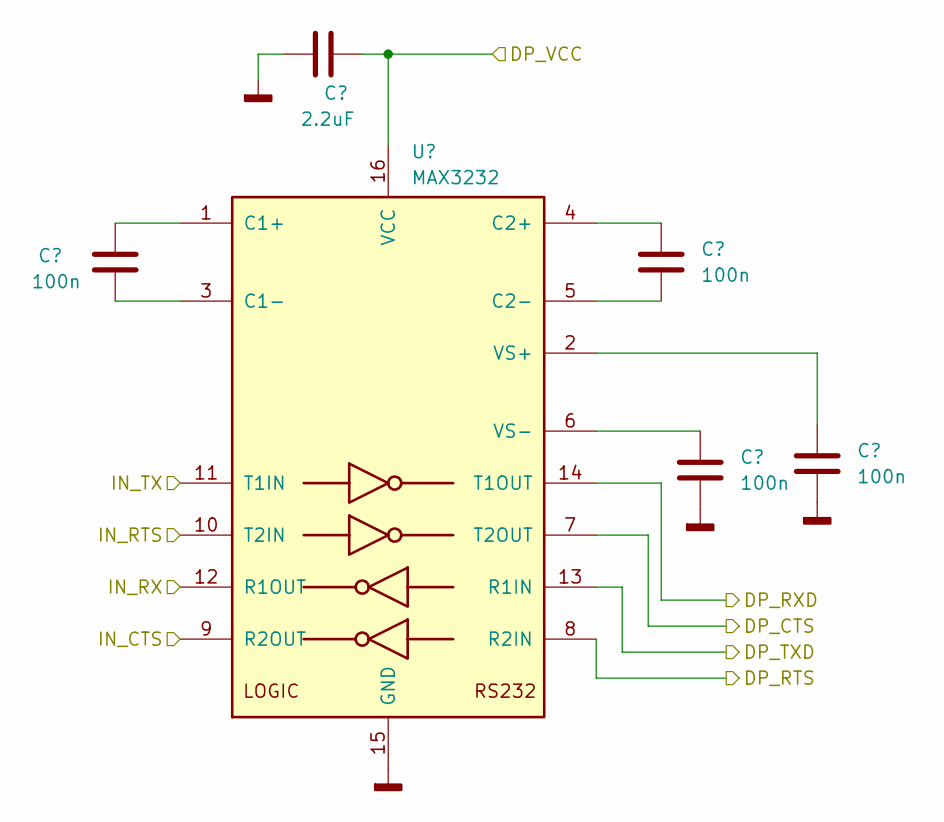
[picture p48: schematic debug_port.kicad_sch]

Parts:
C13: 2.2uF; C_0805_2012Metric
C14, C15, C16, C17: 100n; C_0805_2012Metric
U3: MAX3232; SO-16_5.3x10.2mm_P1.27mm

Connections:
+3.3V: C13.2, U3.16 (VCC); also elsewhere on the board
/CTS1: U3.9 (R2OUT); also elsewhere on the board
/RTS1: U3.10 (T2IN); also elsewhere on the board
/RXD1: U3.12 (R1OUT); also elsewhere on the board
/TXD1: U3.11 (T1IN); also elsewhere on the board
/debug_port/DP_CTS: U3.7 (T2OUT); also elsewhere on the board
/debug_port/DP_RTS: U3.8 (R2IN); also elsewhere on the board
/debug_port/DP_RXD: U3.14 (T1OUT); also elsewhere on the board
/debug_port/DP_TXD: U3.13 (R1IN); also elsewhere on the board
GNDD: C13.1, C16.2, C17.2, U3.15 (GND); also elsewhere on the board
unnamed: C14.1, U3.1 (C1+)
unnamed: C14.2, U3.3 (C1-)
unnamed: C15.1, U3.4 (C2+)
unnamed: C15.2, U3.5 (C2-)
unnamed: C16.1, U3.2 (VS+)
unnamed: C17.1, U3.6 (VS-)

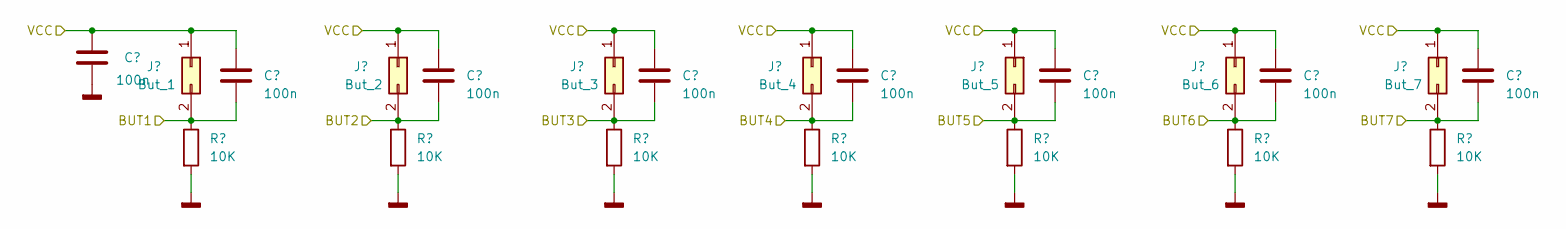
[picture p49: schematic control_btns.kicad_sch]

Parts:
C20, C21, C22, C23, C24, C25, C26, C27: 100n; C_0805_2012Metric
J13: But_1; PinHeader_2x01_P2.54mm_Horizontal
J14: But_2; PinHeader_2x01_P2.54mm_Horizontal
J15: But_3; PinHeader_2x01_P2.54mm_Horizontal
J16: But_4; PinHeader_2x01_P2.54mm_Horizontal
J17: But_5; PinHeader_2x01_P2.54mm_Horizontal
J18: But_6; PinHeader_2x01_P2.54mm_Horizontal
J19: But_7; PinHeader_2x01_P2.54mm_Horizontal
R13, R14, R15, R16, R17, R18, R19: 10K; R_0805_2012Metric

Connections:
+3.3V: C20.1, C21.1, C22.1, C23.1, C24.1, C25.1, C26.1, C27.1, J13.1, J14.1, J15.1, J16.1, J17.1, J18.1, J19.1; also elsewhere on the board
/BUT1: C21.2, J13.2, R13.1; also elsewhere on the board
/BUT2: C22.2, J14.2, R14.1; also elsewhere on the board
/BUT3: C23.2, J15.2, R15.1; also elsewhere on the board
/BUT4: C24.2, J16.2, R16.1; also elsewhere on the board
/BUT5: C25.2, J17.2, R17.1; also elsewhere on the board
/BUT6: C26.2, J18.2, R18.1; also elsewhere on the board
/BUT7: C27.2, J19.2, R19.1; also elsewhere on the board
GNDD: C20.2, R13.2, R14.2, R15.2, R16.2, R17.2, R18.2, R19.2; also elsewhere on the board

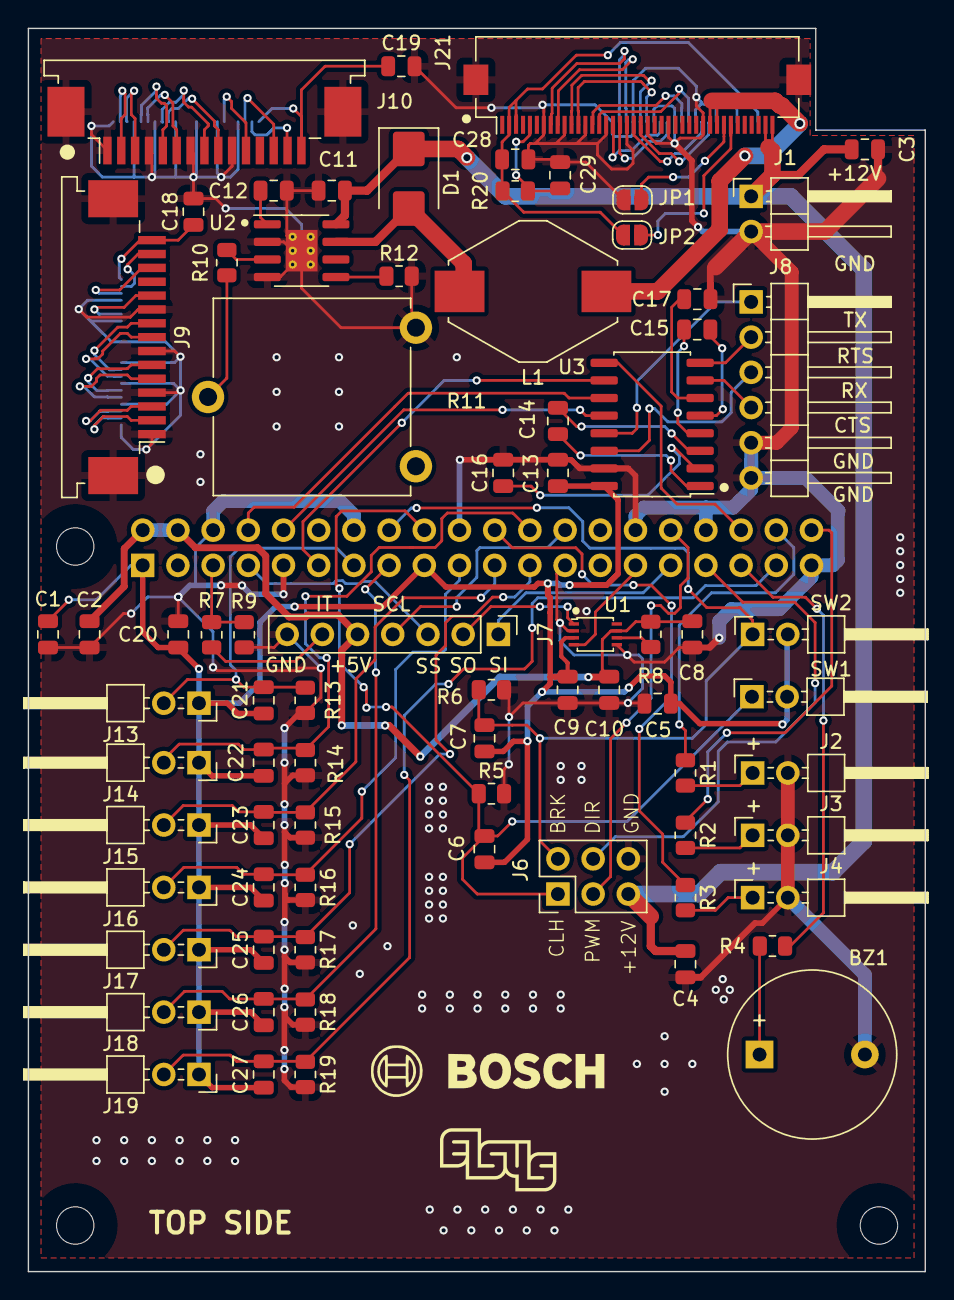
[picture p50: board Shield.kicad_pcb from above]

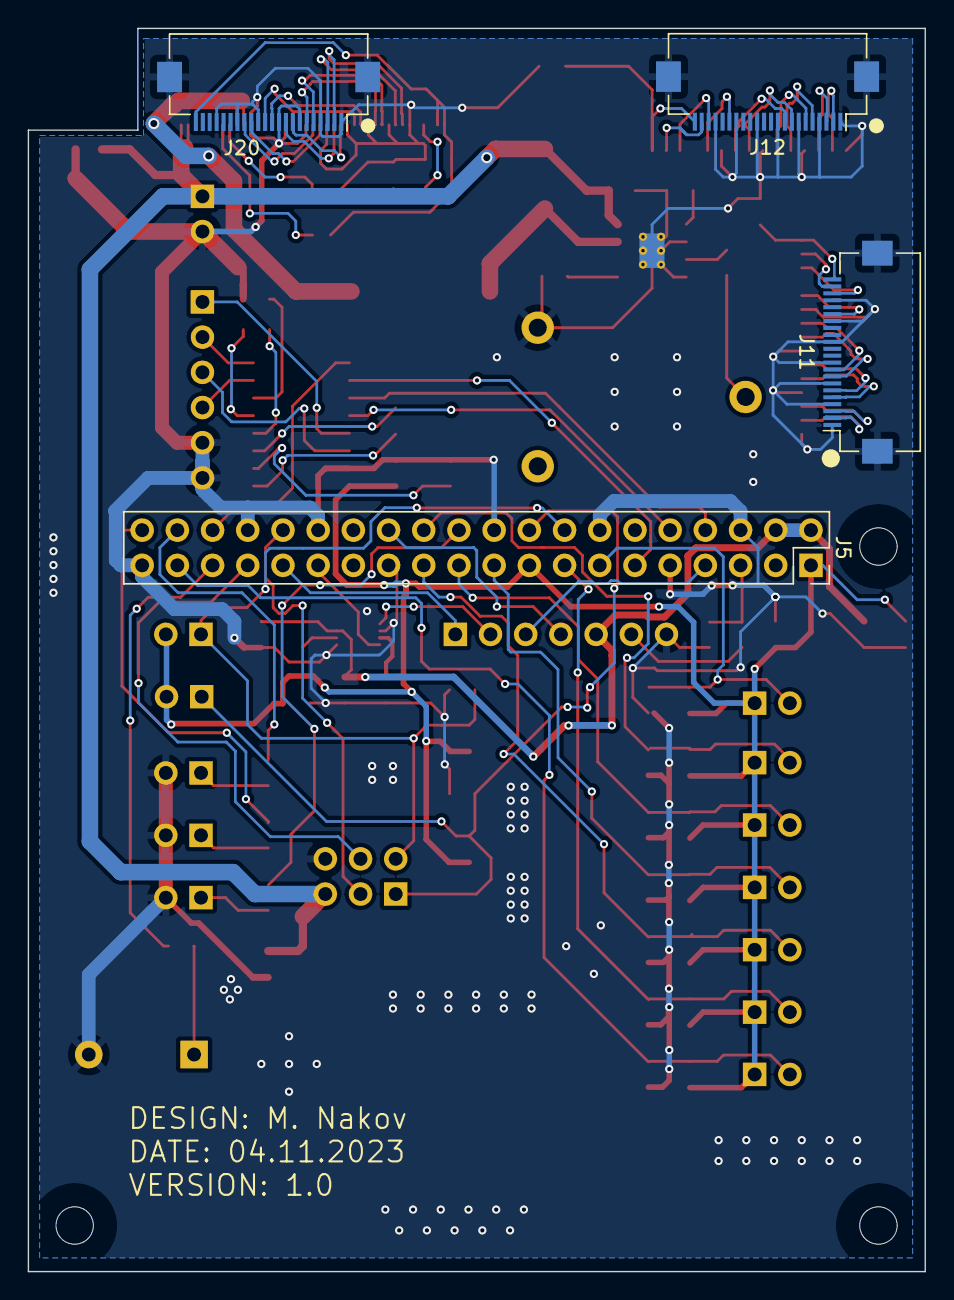
[picture p51: board Shield.kicad_pcb from below]

Board: 2 copper layers, 64.7 x 89.7 mm, 83 parts (4 on the bottom side), 85 nets.

Other parts of the board:
H2, H3, H4: MountingHole; MountingHole_2.7mm_M2.5
