generot/driving-assistance-system/(commit log)

2023-09-07 Pushing docs to repo.
    [components.xlsx]
2023-09-07 Updated components list
    [components.xlsx]
2023-09-08 Simplistic car detection added
    [yolov2-tiny.cfg]
2023-09-10 Strategy update, details in components.xlsx and daily_updates.txt
    [components.xlsx, yolov2-tiny.cfg]
2023-09-12 Implemented acceptable SL recognition with color filtering and Hough transform
2023-09-14 Adding samples
2023-09-15 Made better disparity filtering and implemented basic depth estimation with template matching.
2023-09-21 Minor update, written in docs
    [components.xlsx]
2023-09-27 Made a basic vehicle transmission simulation for the PID controller PoC.
2023-09-28 Wrote an example PID controller
2023-09-28 Bug fix: TSR no longer captures a frame when a matrix with 0 rows (i.e. a line) is provided
    [detect.py, traff_sign.py]
2023-10-13 Implementing camera calibration; augmented car detection algorithm for night driving;
    [requirements.xlsx]
2023-10-24 Pushing all schematics to repo
    [CAN_module.kicad_sch, Shield.kicad_pcb, Shield.kicad_sch, aac.kicad_pcb, aac.kicad_sch, camera_map.kicad_sch, components.xlsx, debug_port.kicad_sch]
2023-11-07 Pushing final schematic and PCB.
    [MAX3232.STEP, Shield.csv, Shield.kicad_pcb, Shield.kicad_sch, Trimmer_Piher_PT-15.step, WE-PD4_Typ_L_4.stp, aac.kicad_pcb, aac.kicad_sch]
2023-11-24 Updating repo with most recent changes
    [Shield-B_Cu.gbr, Shield-B_Mask.gbr, Shield-B_Paste.gbr, Shield-B_Silkscreen.gbr, Shield-Edge_Cuts.gbr, Shield-F_Cu.gbr, Shield-F_Mask.gbr, Shield-F_Paste.gbr]
2024-01-10 Implemented frame pulling from stereo camera set
2024-01-10 Implemented multiprocessing, but unfortunately it doesn't work correctly
    [rpicam.py]
2024-01-14 Implemented device tree overlay for the display.
2024-01-23 Added DTO for the custom driver
2024-01-30 Device Tree Overlays for the CAN Bus implemented
2024-02-03 Car detection and camera calibration setup
